Dharmesh1906/TTL_TicTacToe/Tic_tac_toe_2player/Figures/simple-pulse-generator-by-ic-555-timer-.jpg

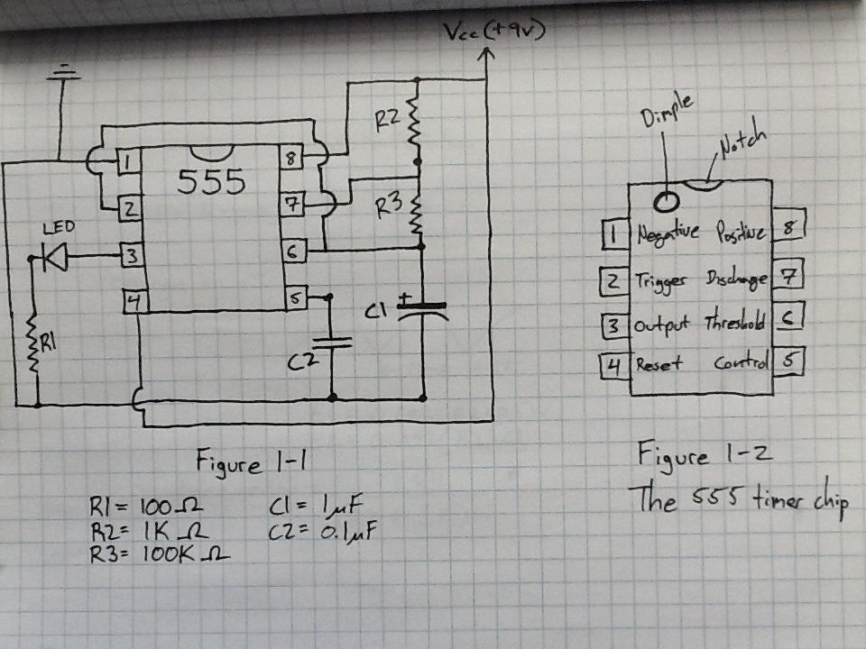
Tic_tac_toe_2player/Figures/simple-pulse-generator-by-ic-555-timer-.jpg
