Dharmesh1906/TTL_TicTacToe/Tic_tac_toe_2player/Figures/Tictactoe.pptx

## Tic Tac Toe In TTL

This is a human versus TTL circuit version of Tic Tac Toe, but with no
CPU. It's all plain old digital logic.

## Slide 2

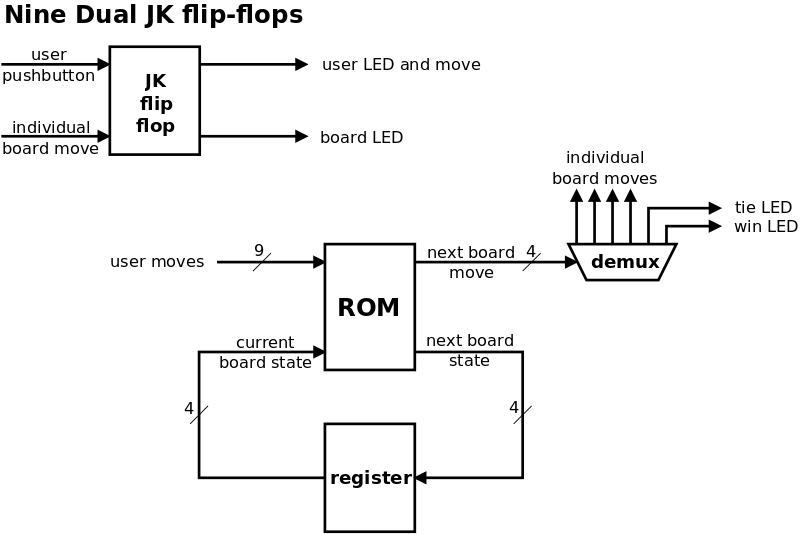
[picture p2: figure]
A screenshot of a cell phone Description generated with high confidence

## 555 Timer

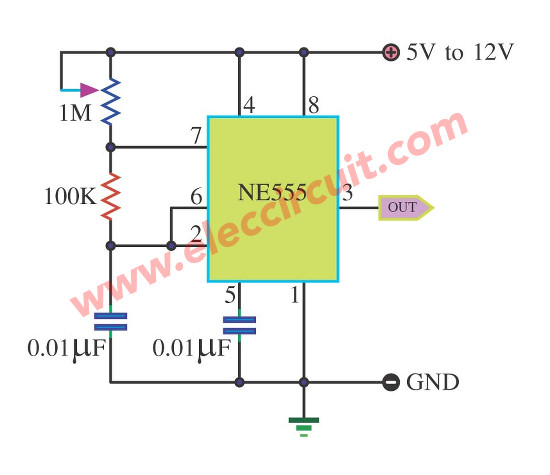
[picture p3: figure]
A close up of text on a white background Description generated with very high confidence

## Slide 4

- User Moves

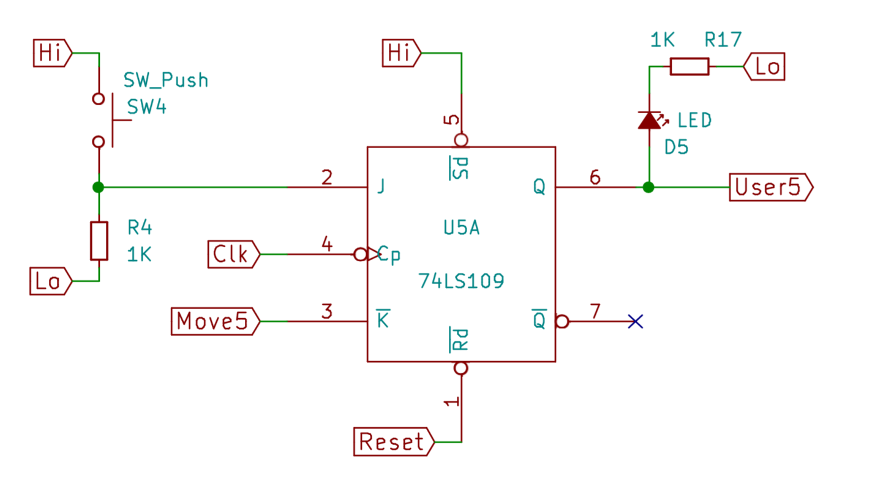
[picture p4: figure]
A close up of a map Description generated with very high confidence

## Slide 5

- Board Moves

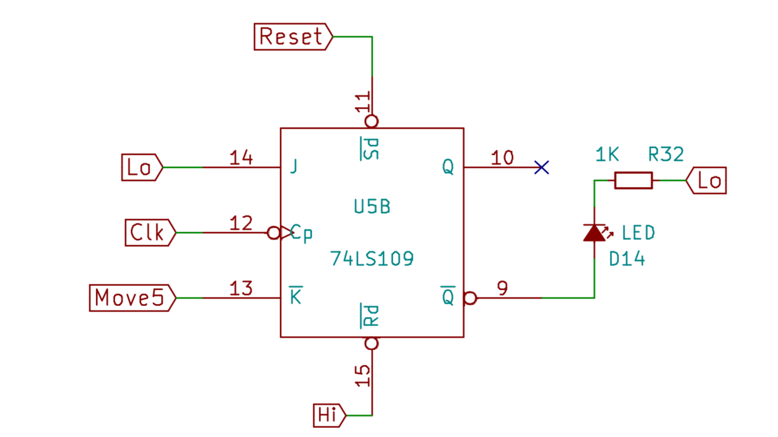
[picture p5: figure]
A screenshot of text Description generated with very high confidence

## Slide 6
