Dharmesh1906/TTL_TicTacToe/Tic_tac_toe_2player/Figures/Screenshot (37).png

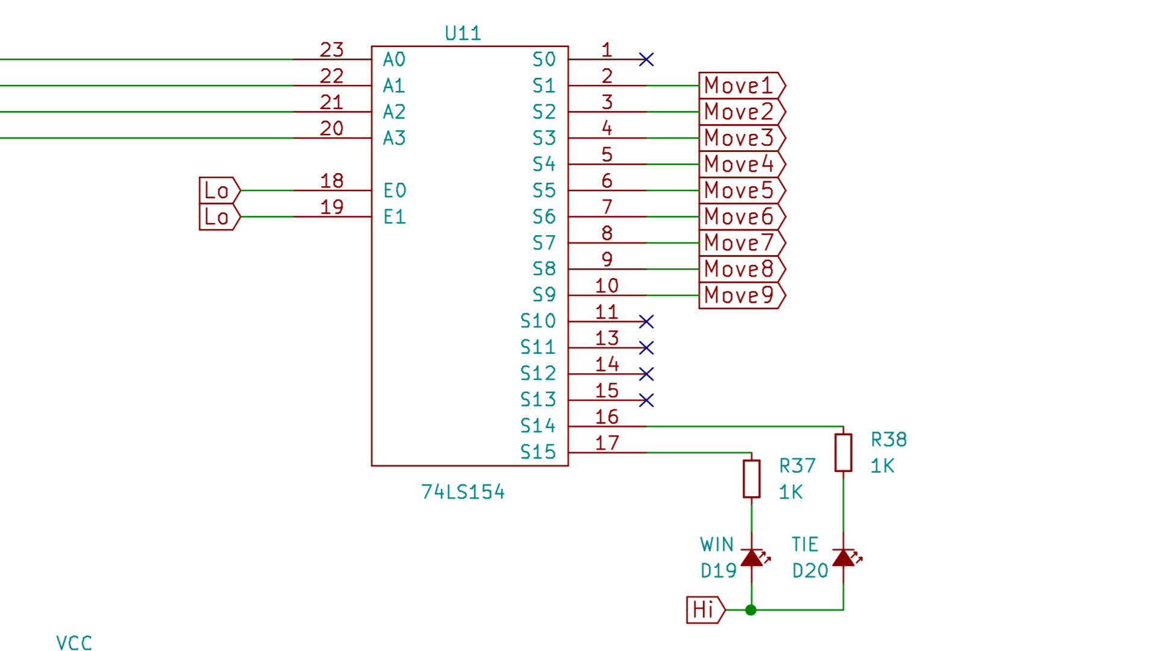
Tic_tac_toe_2player/Figures/Screenshot (37).png
