Dharmesh1906/TTL_TicTacToe/Tic_tac_toe_2player/Figures/brown pcb.pdf

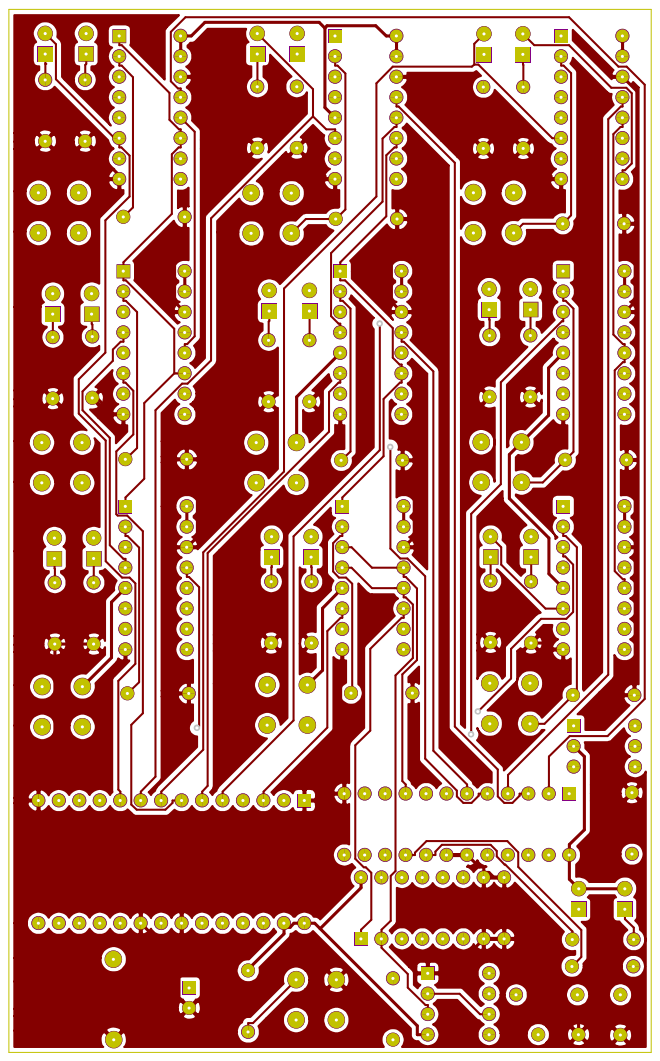
[picture p9: page 1]
