Dharmesh1906/TTL_TicTacToe/Tic_tac_toe_2player/Figures/green pcb.pdf

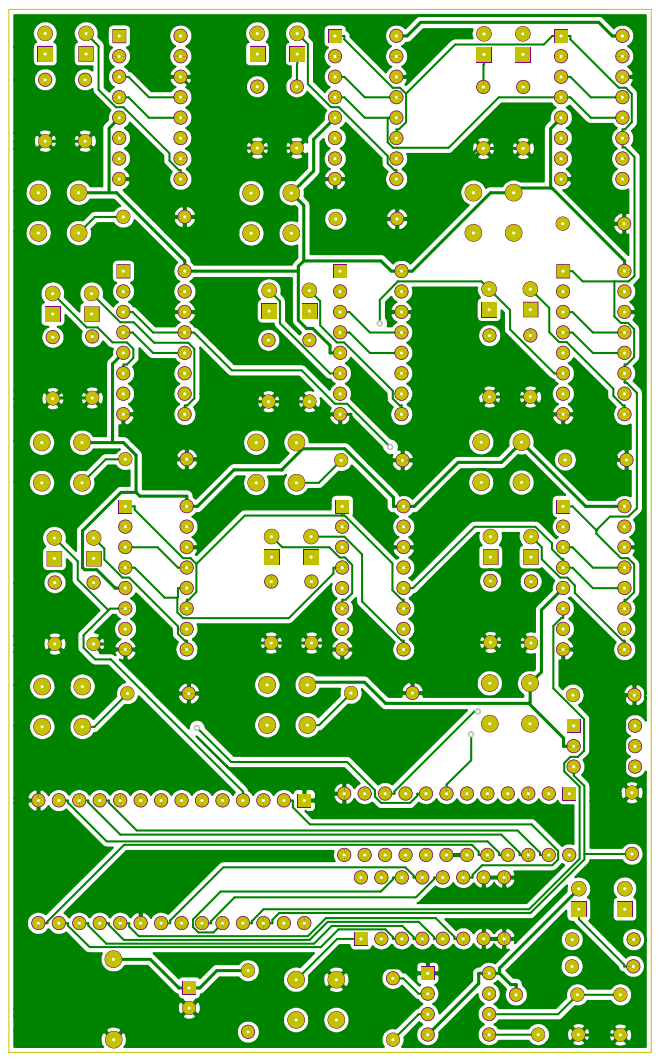
[picture p10: page 1]
