Dharmesh1906/TTL_TicTacToe/Tic_tac_toe_2player/Figures/pcb.pdf

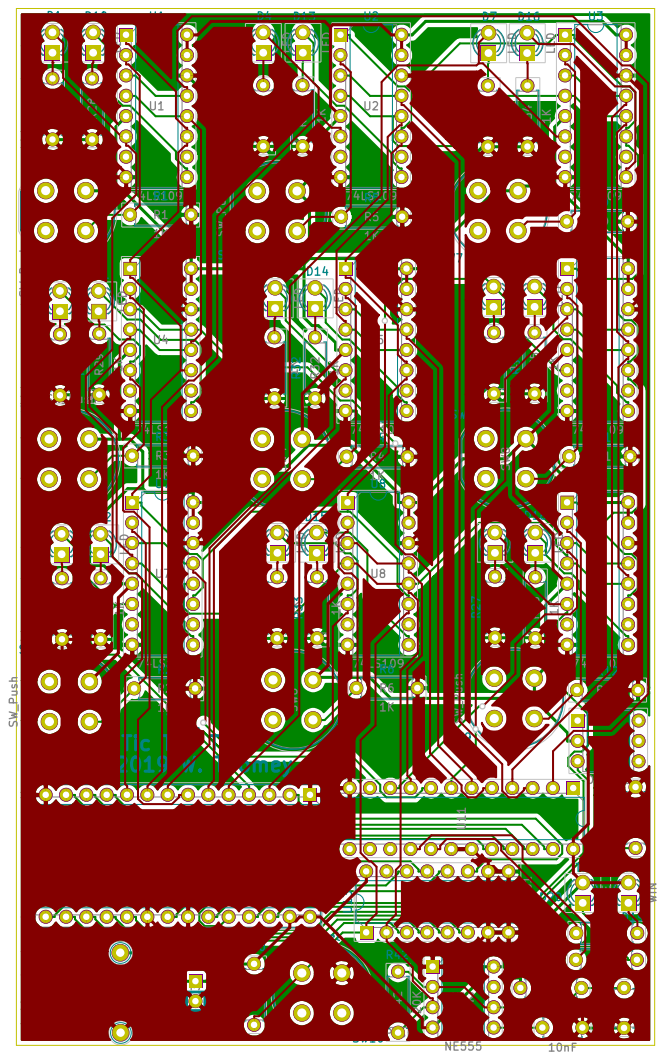
[picture p11: page 1]
