Dharmesh1906/TTL_TicTacToe/Tic_tac_toe_2player/Figures/pcb_bw.pdf

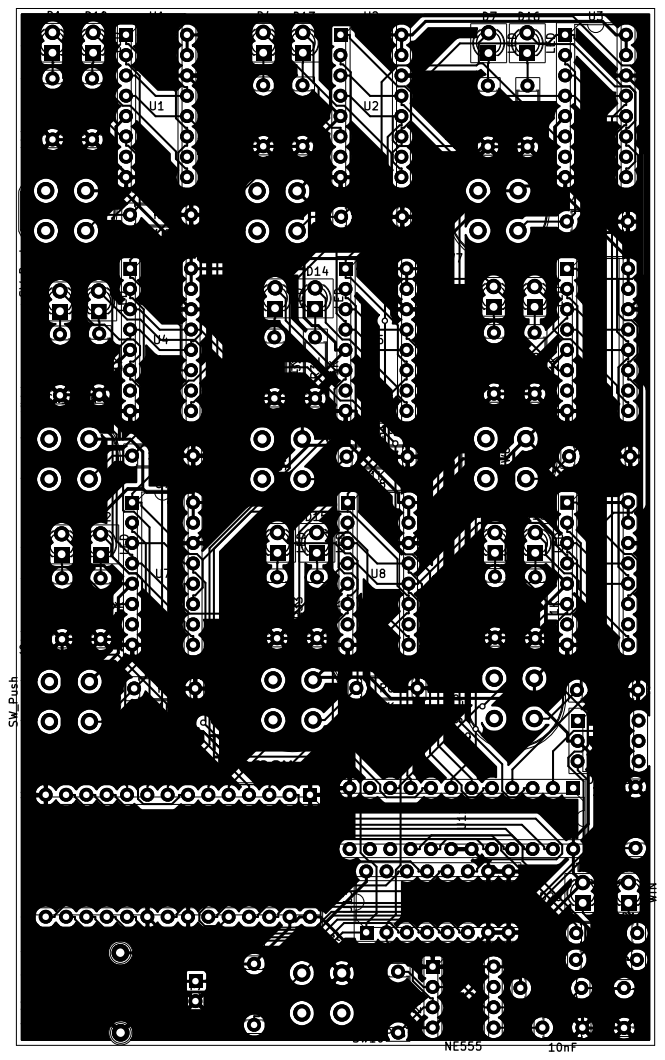
[picture p12: page 1]
