Dharmesh1906/TTL_TicTacToe/(list of files, drawings)

Other design files:
Tic_tac_toe_2player/Tic_tac_toe_2_players.circ
